jonscheiding/phone-ringer/waveform.png

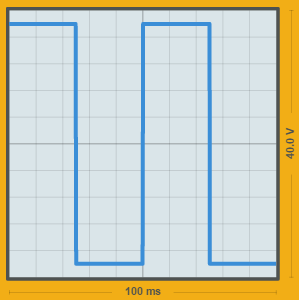
waveform.png
