jonscheiding/phone-ringer/(threads)

Thread 1 (2022-06-06):

Phase 4 schematic looks to be incomplete

wa6pzb, 2022-06-06:
Reviewing your work I noticed the H-Bridge is not fully connected to the step-up transformer through the RC network.

Thanks for posting this, I am actual building something similar using two relays as the H-bridge.

jonscheiding, 2022-06-15:
Thanks for the comment! It's been so long since I looked at this, the context is totally gone 🤣 can you point me to where the missing connection is?
