jonscheiding/phone-ringer/(commit log)

2017-03-21 Updated with code and diagram for first step, generating a 5V/20Hz square wave
2017-03-21 Added transformer to step up voltage and make the phone actually ring.
2017-03-21 Updated to generate 18v with a boost converter
2017-04-10 Added a current-limiting resistor in series with the phone.
2017-04-10 Updated firmware to use PWM for sine wave simulation.
2017-04-10 Added NPM util to generate the PWM lookup table.
2017-04-10 Updated to describe PWM generation and added some documentation to the generation code
2017-04-10 Added information about RC filter
2017-04-10 Updated firmware to support activating with a button
2017-04-11 Updated firmware to use interrupts for button
2017-04-17 Added LED indication when active
2017-04-27 Fixed a bug that caused one leg of AC signal to stay on when not ringing
    [phone-ringer.ino]
2017-04-27 Tweak PWM generation to make it easier to adjust frequency in testing
